r2p-old/uDC_module/hw/uDC_module.brd

## EAGLE design hw/uDC_module.brd (2015-01-22)

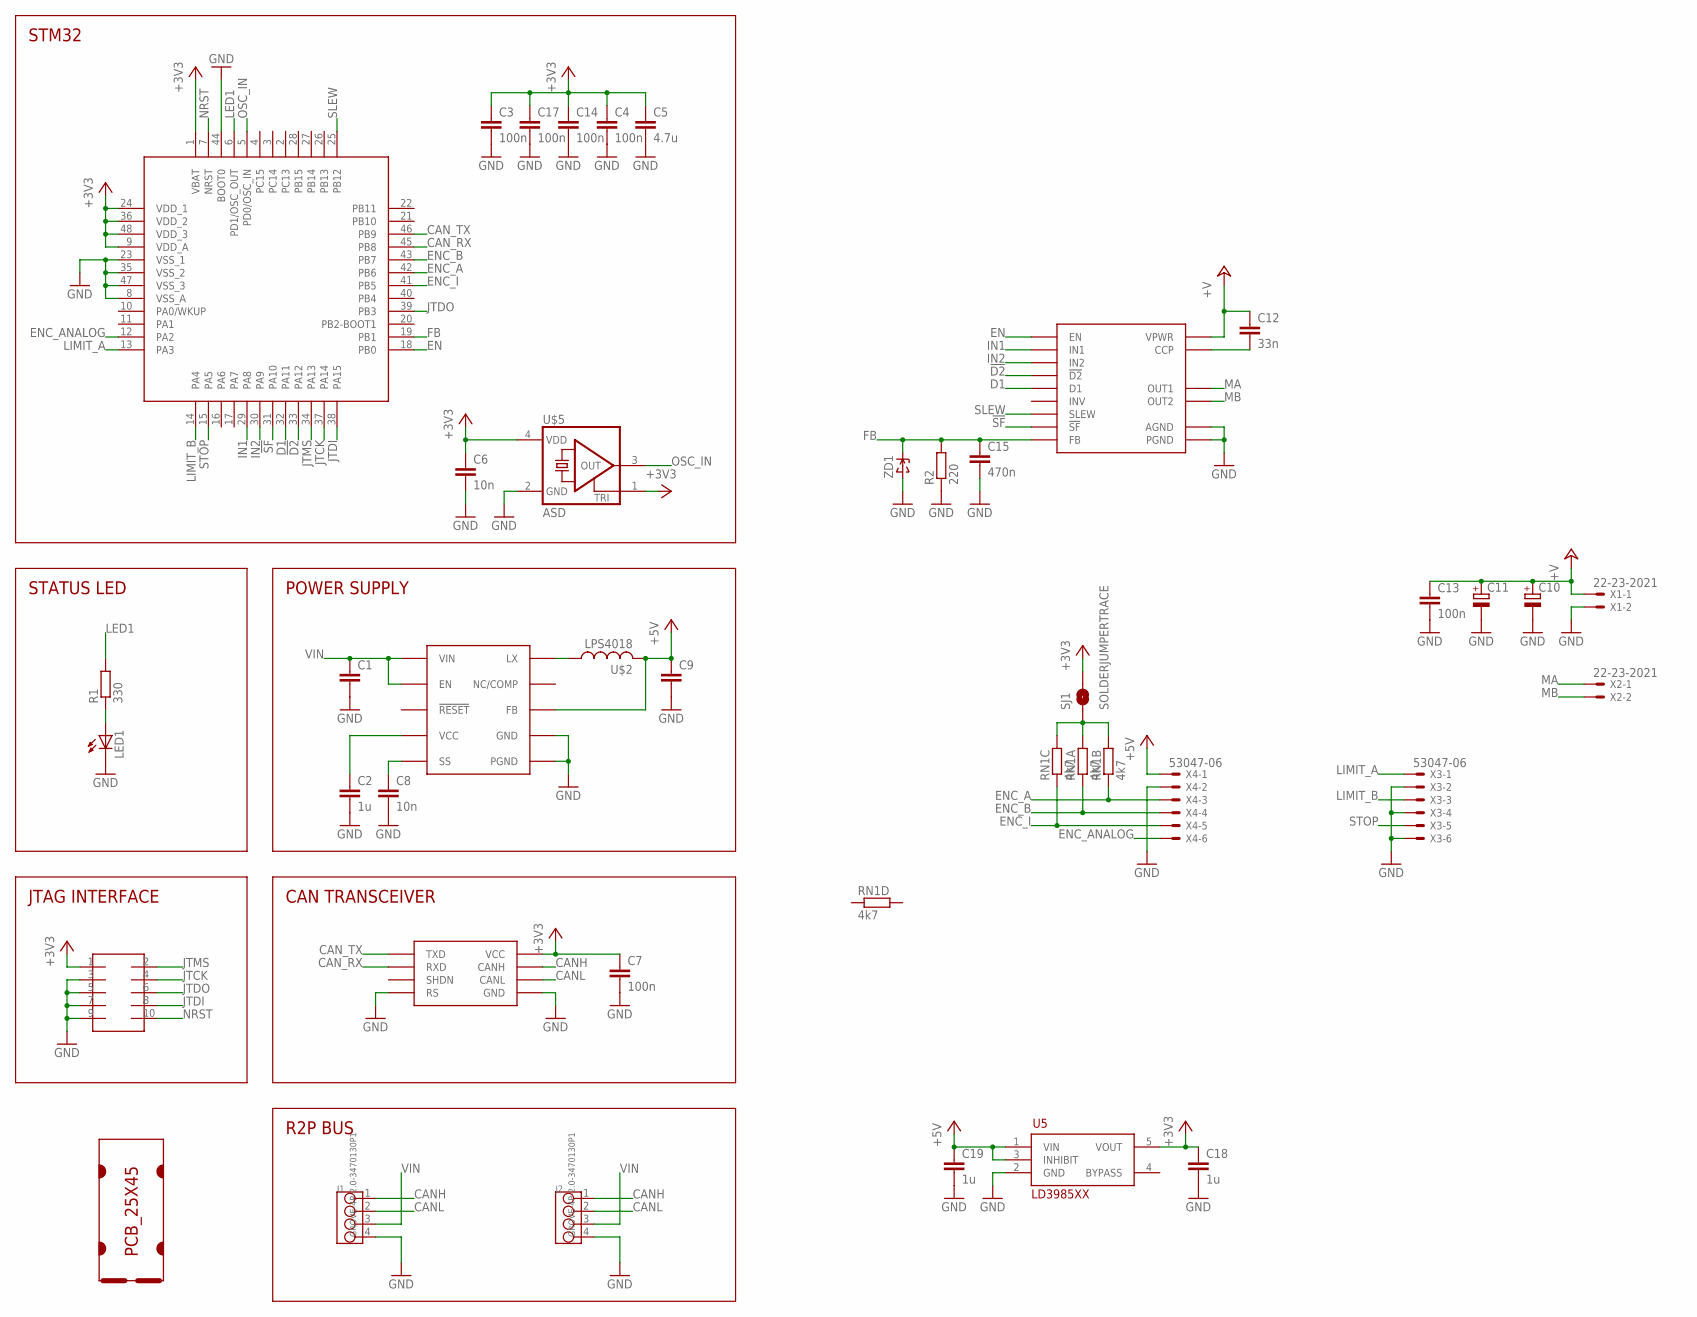
[picture p1: schematic uDC_module.sch]

Parts:
C1: C-EUC1206; C1206
C2, C18, C19: 1u; C0603
C3, C4, C7, C13, C14, C17: 100n; C0603
C5: 4.7u; C0805
C6, C8: 10n; C0603
C9: C-EUC0805; C0805
C10, C11: CPOL-EUD; PANASONIC_D
C12: 33n; C0603
C15: 470n; C0603
J1, J2: GROVE-4P-2.0-3470130P1; 4P-2.0
LED1: LEDCHIPLED_0805; CHIPLED_0805
R1: 330; R0603
R2: 220; R0603
RN1: 4k7; RN8P-4R-CRA06S
SJ1: SOLDERJUMPERTRACE; SJ_2S-TRACE
SOT1: MAX3051EKA; SOT23-8L
U5: LD3985XX; SOT23-5L
U$1: PCB_25X45; 25X45
U$2: LPS4018
U$3: MAX17501; TDFN-10
U$4: FTSH-105TH; FTSH-105-TH
U$5: ASD; 2.5X2
U$6: STM32F103CXTX; LQFP48
U$7: MC33962; PQFN32
X1, X2: 22-23-2021
X3, X4: 53047-06
ZD1: ZENERSOD-323F; SOD-323F

Connections:
!D2: U$6.33 (PA12), U$7.P$16 (!D2)
!SF: U$6.31 (PA10), U$7.P$21 (!SF)
+3V3: C3.1, C4.1, C5.1, C6.1, C7.1, C14.1, C17.1, C18.1, SJ1.2, SOT1.3 (VCC), U5.5 (VOUT), U$4.1, U$5.1 (TRI), U$5.4 (VDD), U$6.1 (VBAT), U$6.9 (VDD_A), U$6.24 (VDD_1), U$6.36 (VDD_2), U$6.48 (VDD_3)
+5V: C9.1, C19.1, U5.1 (VIN), U5.3 (INHIBIT), U$2.P$2 (2), U$3.P$5 (FB), X4.1
+V: C10.+, C11.+, C12.1, C13.1, U$7.P$4 (VPWR), U$7.P$6 (VPWR), U$7.P$11 (VPWR), U$7.P$31 (VPWR), X1.1
CANH: J1.1, J2.1, SOT1.7 (CANH)
CANL: J1.2, J2.2, SOT1.6 (CANL)
CAN_RX: SOT1.4 (RXD), U$6.45 (PB8)
CAN_TX: SOT1.1 (TXD), U$6.46 (PB9)
D1: U$6.32 (PA11), U$7.P$26 (D1)
EN: U$6.18 (PB0), U$7.P$10 (EN)
ENC_A: RN1.2 (1), U$6.42 (PB6), X4.3
ENC_ANALOG: U$6.12 (PA2), X4.6
ENC_B: RN1.1, U$6.43 (PB7), X4.4
ENC_I: RN1.3 (1), U$6.41 (PB5), X4.5
FB: C15.1, R2.2, U$6.19 (PB1), U$7.P$8 (FB), ZD1.C
GND: C1.2, C2.2, C3.2, C4.2, C5.2, C6.2, C7.2, C8.2, C9.2, C10.-, C11.-, C13.2, C14.2, C15.2, C17.2, C18.2, C19.2, J1.4, J2.4, LED1.C, R2.1, SOT1.2 (GND), SOT1.8 (RS), U5.2 (GND), U$3.P$1 (PGND), U$3.P$9 (GND), U$3.P$11 (PGND), U$4.3, U$4.5, U$4.7, U$4.9, U$5.2 (GND), U$6.8 (VSS_A), U$6.23 (VSS_1), U$6.35 (VSS_2), U$6.44 (BOOT0), U$6.47 (VSS_3), U$7.P$5 (AGND), U$7.P$18 (PGND), U$7.P$19 (PGND), U$7.P$20 (PGND), U$7.P$22 (PGND), U$7.P$23 (PGND), U$7.P$24 (PGND), U$7.P$33 (AGND), X1.2, X3.2, X3.4, X3.6, X4.2, ZD1.A
IN1: U$6.29 (PA8), U$7.P$2 (IN1)
IN2: U$6.30 (PA9), U$7.P$1 (IN2)
JTCK: U$4.4, U$6.37 (PA14)
JTDI: U$4.8, U$6.38 (PA15)
JTDO: U$4.6, U$6.39 (PB3)
JTMS: U$4.2, U$6.34 (PA13)
LED1: R1.2, U$6.6 (PD1/OSC_OUT)
LIMIT_A: U$6.13 (PA3), X3.1
LIMIT_B: U$6.14 (PA4), X3.3
MA: U$7.P$12 (OUT1), U$7.P$13 (OUT1), U$7.P$14 (OUT1), U$7.P$15 (OUT1), X2.1
MB: U$7.P$27 (OUT2), U$7.P$28 (OUT2), U$7.P$29 (OUT2), U$7.P$30 (OUT2), X2.2
unnamed: U$2.P$1 (1), U$3.P$10 (LX)
unnamed: LED1.A, R1.1
unnamed: RN1.6 (2), RN1.7 (2), RN1.8 (2), SJ1.1
unnamed: C12.2, U$7.P$32 (CCP)
unnamed: C2.1, U$3.P$4 (VCC)
unnamed: C8.1, U$3.P$6 (SS)
NRST: U$4.10, U$6.7 (NRST)
OSC_IN: U$5.3 (OUT), U$6.5 (PD0/OSC_IN)
SLEW: U$6.25 (PB12), U$7.P$3 (SLEW)
STOP: U$6.15 (PA5), X3.5
VIN: C1.1, J1.3, J2.3, U$3.P$2 (VIN), U$3.P$3 (EN)

Notes on the sheet:
STM32
STATUS LED
JTAG INTERFACE
POWER SUPPLY
CAN TRANSCEIVER
R2P BUS

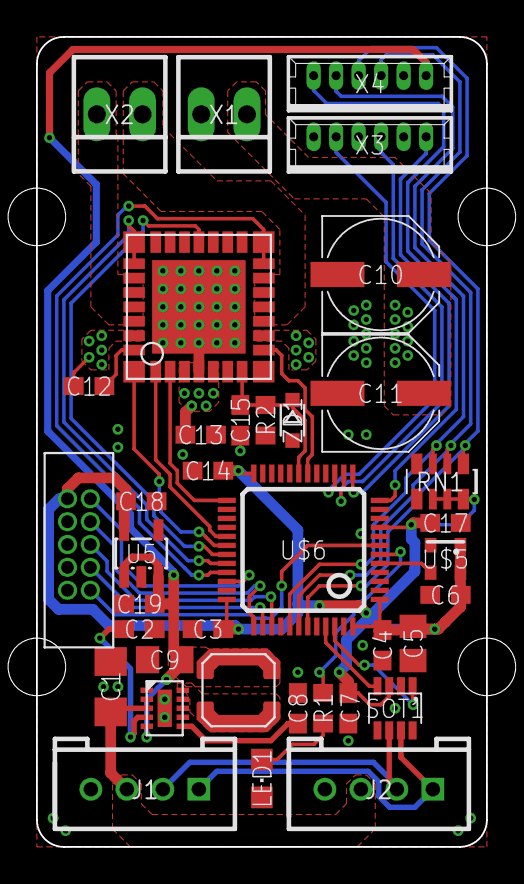
[picture p2: board uDC_module.brd from above]

Board: 2 copper layers, 25.0 x 45.0 mm, 39 parts (1 on the bottom side), 39 nets.
