r2p-old/uDC_module/fw/board.h

/*
    ChibiOS/RT - Copyright (C) 2006-2013 Giovanni Di Sirio

    Licensed under the Apache License, Version 2.0 (the "License");
    you may not use this file except in compliance with the License.
    You may obtain a copy of the License at

        http://www.apache.org/licenses/LICENSE-2.0

    Unless required by applicable law or agreed to in writing, software
    distributed under the License is distributed on an "AS IS" BASIS,
    WITHOUT WARRANTIES OR CONDITIONS OF ANY KIND, either express or implied.
    See the License for the specific language governing permissions and
    limitations under the License.
*/

#ifndef _BOARD_H_
#define _BOARD_H_

/*
 * Setup for R2P uDC module board.
 */

/*
 * Board identifier.
 */
#define BOARD_R2P_uDC_module
#define BOARD_NAME                  "R2P uDC module"

/*
 * Board oscillators-related settings.
 * NOTE: LSE not fitted.
 */
#if !defined(STM32_LSECLK)
#define STM32_LSECLK                0
#endif

#define STM32_LSEDRV                (3 << 3)

#if !defined(STM32_HSECLK)
#define STM32_HSECLK                24000000
#endif

#define STM32_HSE_BYPASS

#define PWM_DRIVER PWMD1
#define QEI_DRIVER QEID4


/*
 * MCU type as defined in the ST header.
 */
#define STM32F30X

/*
 * IO pins assignments.
 */
#define GPIOA_PIN0                  0
#define GPIOA_PIN1                  1
#define GPIOA_ENCODER_ANALOG        2
#define GPIOA_SWITCH_A              3
#define GPIOA_SWITCH_B              4
#define GPIOA_SWITCH_STOP           5
#define GPIOA_PIN6                  6
#define GPIOA_PIN7                  7
#define GPIOA_MOTOR_IN1             8
#define GPIOA_MOTOR_IN2             9
#define GPIOA_MOTOR_SF              10
#define GPIOA_MOTOR_D1              11
#define GPIOA_MOTOR_D2              12
#define GPIOA_JTAG_TMS              13
#define GPIOA_JTAG_TCK              14
#define GPIOA_JTAG_TDI              15

#define GPIOB_MOTOR_ENABLE          0
#define GPIOB_MOTOR_FEEDBACK        1
#define GPIOB_BOOT1                 2
#define GPIOB_JTAG_TDO              3
#define GPIOB_JTAG_TRST             4
#define GPIOB_ENCODER_I             5
#define GPIOB_ENCODER_A             6
#define GPIOB_ENCODER_B             7
#define GPIOB_CAN_RX                8
#define GPIOB_CAN_TX                9
#define GPIOB_PIN10                 10
#define GPIOB_PIN11                 11
#define GPIOB_MOTOR_SLEW            12
#define GPIOB_PIN13                 13
#define GPIOB_PIN14                 14
#define GPIOB_PIN15                 15

#define GPIOC_PIN0                  0
#define GPIOC_PIN1                  1
#define GPIOC_PIN2                  2
#define GPIOC_PIN3                  3
#define GPIOC_PIN4                  4
#define GPIOC_PIN5                  5
#define GPIOC_PIN6                  6
#define GPIOC_PIN7                  7
#define GPIOC_PIN8                  8
#define GPIOC_PIN9                  9
#define GPIOC_PIN10                 10
#define GPIOC_PIN11                 11
#define GPIOC_PIN12                 12
#define GPIOC_LED                   13
#define GPIOC_OSC32_IN              14
#define GPIOC_OSC32_OUT             15

#define GPIOD_PIN0                  0
#define GPIOD_PIN1                  1
#define GPIOD_PIN2                  2
#define GPIOD_PIN3                  3
#define GPIOD_PIN4                  4
#define GPIOD_PIN5                  5
#define GPIOD_PIN6                  6
#define GPIOD_PIN7                  7
#define GPIOD_PIN8                  8
#define GPIOD_PIN9                  9
#define GPIOD_PIN10                 10
#define GPIOD_PIN11                 11
#define GPIOD_PIN12                 12
#define GPIOD_PIN13                 13
#define GPIOD_PIN14                 14
#define GPIOD_PIN15                 15

#define GPIOE_PIN0                  0
#define GPIOE_PIN1                  1
#define GPIOE_PIN2                  2
#define GPIOE_PIN3                  3
#define GPIOE_PIN4                  4
#define GPIOE_PIN5                  5
#define GPIOE_PIN6                  6
#define GPIOE_PIN7                  7
#define GPIOE_PIN8                  8
#define GPIOE_PIN9                  9
#define GPIOE_PIN10                 10
#define GPIOE_PIN11                 11
#define GPIOE_PIN12                 12
#define GPIOE_PIN13                 13
#define GPIOE_PIN14                 14
#define GPIOE_PIN15                 15

#define GPIOF_PIN0                  0
#define GPIOF_LED                   1
#define GPIOF_PIN2                  2
#define GPIOF_PIN3                  3
#define GPIOF_PIN4                  4
#define GPIOF_PIN5                  5
#define GPIOF_PIN6                  6
#define GPIOF_PIN7                  7
#define GPIOF_PIN8                  8
#define GPIOF_PIN9                  9
#define GPIOF_PIN10                 10
#define GPIOF_PIN11                 11
#define GPIOF_PIN12                 12
#define GPIOF_PIN13                 13
#define GPIOF_PIN14                 14
#define GPIOF_PIN15                 15

#define LED1_GPIO	GPIOC
#define LED2_GPIO	GPIOC
#define LED3_GPIO	GPIOC
#define LED4_GPIO	GPIOC
#define LED1		13
#define LED2		13
#define LED3		13
#define LED4		13

/*
 * I/O ports initial setup, this configuration is established soon after reset
 * in the initialization code.
 * Please refer to the STM32 Reference Manual for details.
 */
#define PIN_MODE_INPUT(n)           (0U << ((n) * 2))
#define PIN_MODE_OUTPUT(n)          (1U << ((n) * 2))
#define PIN_MODE_ALTERNATE(n)       (2U << ((n) * 2))
#define PIN_MODE_ANALOG(n)          (3U << ((n) * 2))
#define PIN_ODR_LOW(n)              (0U << (n))
#define PIN_ODR_HIGH(n)             (1U << (n))
#define PIN_OTYPE_PUSHPULL(n)       (0U << (n))
#define PIN_OTYPE_OPENDRAIN(n)      (1U << (n))
#define PIN_OSPEED_2M(n)            (0U << ((n) * 2))
#define PIN_OSPEED_25M(n)           (1U << ((n) * 2))
#define PIN_OSPEED_50M(n)           (2U << ((n) * 2))
#define PIN_OSPEED_100M(n)          (3U << ((n) * 2))
#define PIN_PUPDR_FLOATING(n)       (0U << ((n) * 2))
#define PIN_PUPDR_PULLUP(n)         (1U << ((n) * 2))
#define PIN_PUPDR_PULLDOWN(n)       (2U << ((n) * 2))
#define PIN_AFIO_AF(n, v)           ((v##U) << ((n % 8) * 4))

/*
 * GPIOA setup:
 *
 * PA0  - PIN0                      (input pullup).
 * PA1  - PIN1                      (input pullup).
 * PA2  - ENCODER_ANALOG            (analog).
 * PA3  - SWITCH_A                  (input pullup).
 * PA4  - SWITCH_B                  (input pullup).
 * PA5  - SWITCH_STOP               (input pullup).
 * PA6  - PIN6                      (input pullup).
 * PA7  - PIN7                      (input pullup).
 * PA8  - MOTOR_IN1                 (alternate 6).
 * PA9  - MOTOR_IN2                 (alternate 6).
 * PA10 - MOTOR_SF                  (input pullup).
 * PA11 - MOTOR_D1                  (output pushpull maximum).
 * PA12 - MOTOR_D2                  (output pushpull maximum).
 * PA13 - JTAG_TMS                  (alternate 0).
 * PA14 - JTAG_TCK                  (alternate 0).
 * PA15 - JTAG_TDI                  (alternate 0).
 */
#define VAL_GPIOA_MODER             (PIN_MODE_INPUT(GPIOA_PIN0) |           \
                                     PIN_MODE_INPUT(GPIOA_PIN1) |           \
                                     PIN_MODE_ANALOG(GPIOA_ENCODER_ANALOG) |\
                                     PIN_MODE_INPUT(GPIOA_SWITCH_A) |       \
                                     PIN_MODE_INPUT(GPIOA_SWITCH_B) |       \
                                     PIN_MODE_INPUT(GPIOA_SWITCH_STOP) |    \
                                     PIN_MODE_INPUT(GPIOA_PIN6) |           \
                                     PIN_MODE_INPUT(GPIOA_PIN7) |           \
                                     PIN_MODE_ALTERNATE(GPIOA_MOTOR_IN1) |  \
                                     PIN_MODE_ALTERNATE(GPIOA_MOTOR_IN2) |  \
                                     PIN_MODE_INPUT(GPIOA_MOTOR_SF) |       \
                                     PIN_MODE_OUTPUT(GPIOA_MOTOR_D1) |      \
                                     PIN_MODE_OUTPUT(GPIOA_MOTOR_D2) |      \
                                     PIN_MODE_ALTERNATE(GPIOA_JTAG_TMS) |   \
                                     PIN_MODE_ALTERNATE(GPIOA_JTAG_TCK) |   \
                                     PIN_MODE_ALTERNATE(GPIOA_JTAG_TDI))
#define VAL_GPIOA_OTYPER            (PIN_OTYPE_PUSHPULL(GPIOA_PIN0) |       \
                                     PIN_OTYPE_PUSHPULL(GPIOA_PIN1) |       \
                                     PIN_OTYPE_PUSHPULL(GPIOA_ENCODER_ANALOG) |\
                                     PIN_OTYPE_PUSHPULL(GPIOA_SWITCH_A) |   \
                                     PIN_OTYPE_PUSHPULL(GPIOA_SWITCH_B) |   \
                                     PIN_OTYPE_PUSHPULL(GPIOA_SWITCH_STOP) |\
                                     PIN_OTYPE_PUSHPULL(GPIOA_PIN6) |       \
                                     PIN_OTYPE_PUSHPULL(GPIOA_PIN7) |       \
                                     PIN_OTYPE_PUSHPULL(GPIOA_MOTOR_IN1) |  \
                                     PIN_OTYPE_PUSHPULL(GPIOA_MOTOR_IN2) |  \
                                     PIN_OTYPE_PUSHPULL(GPIOA_MOTOR_SF) |   \
                                     PIN_OTYPE_PUSHPULL(GPIOA_MOTOR_D1) |   \
                                     PIN_OTYPE_PUSHPULL(GPIOA_MOTOR_D2) |   \
                                     PIN_OTYPE_PUSHPULL(GPIOA_JTAG_TMS) |   \
                                     PIN_OTYPE_PUSHPULL(GPIOA_JTAG_TCK) |   \
                                     PIN_OTYPE_PUSHPULL(GPIOA_JTAG_TDI))
#define VAL_GPIOA_OSPEEDR           (PIN_OSPEED_2M(GPIOA_PIN0) |            \
                                     PIN_OSPEED_2M(GPIOA_PIN1) |            \
                                     PIN_OSPEED_2M(GPIOA_ENCODER_ANALOG) |  \
                                     PIN_OSPEED_100M(GPIOA_SWITCH_A) |      \
                                     PIN_OSPEED_100M(GPIOA_SWITCH_B) |      \
                                     PIN_OSPEED_100M(GPIOA_SWITCH_STOP) |   \
                                     PIN_OSPEED_2M(GPIOA_PIN6) |            \
                                     PIN_OSPEED_2M(GPIOA_PIN7) |            \
                                     PIN_OSPEED_100M(GPIOA_MOTOR_IN1) |     \
                                     PIN_OSPEED_100M(GPIOA_MOTOR_IN2) |     \
                                     PIN_OSPEED_100M(GPIOA_MOTOR_SF) |      \
                                     PIN_OSPEED_100M(GPIOA_MOTOR_D1) |      \
                                     PIN_OSPEED_100M(GPIOA_MOTOR_D2) |      \
                                     PIN_OSPEED_100M(GPIOA_JTAG_TMS) |      \
                                     PIN_OSPEED_100M(GPIOA_JTAG_TCK) |      \
                                     PIN_OSPEED_100M(GPIOA_JTAG_TDI))
#define VAL_GPIOA_PUPDR             (PIN_PUPDR_PULLUP(GPIOA_PIN0) |         \
                                     PIN_PUPDR_PULLUP(GPIOA_PIN1) |         \
                                     PIN_PUPDR_FLOATING(GPIOA_ENCODER_ANALOG) |\
                                     PIN_PUPDR_PULLUP(GPIOA_SWITCH_A) |     \
                                     PIN_PUPDR_PULLUP(GPIOA_SWITCH_B) |     \
                                     PIN_PUPDR_PULLUP(GPIOA_SWITCH_STOP) |  \
                                     PIN_PUPDR_PULLUP(GPIOA_PIN6) |         \
                                     PIN_PUPDR_PULLUP(GPIOA_PIN7) |         \
                                     PIN_PUPDR_FLOATING(GPIOA_MOTOR_IN1) |  \
                                     PIN_PUPDR_FLOATING(GPIOA_MOTOR_IN2) |  \
                                     PIN_PUPDR_PULLUP(GPIOA_MOTOR_SF) |     \
                                     PIN_PUPDR_FLOATING(GPIOA_MOTOR_D1) |   \
                                     PIN_PUPDR_FLOATING(GPIOA_MOTOR_D2) |   \
                                     PIN_PUPDR_PULLUP(GPIOA_JTAG_TMS) |     \
                                     PIN_PUPDR_PULLDOWN(GPIOA_JTAG_TCK) |   \
                                     PIN_PUPDR_PULLUP(GPIOA_JTAG_TDI))
#define VAL_GPIOA_ODR               (PIN_ODR_HIGH(GPIOA_PIN0) |             \
                                     PIN_ODR_HIGH(GPIOA_PIN1) |             \
                                     PIN_ODR_HIGH(GPIOA_ENCODER_ANALOG) |   \
                                     PIN_ODR_HIGH(GPIOA_SWITCH_A) |         \
                                     PIN_ODR_HIGH(GPIOA_SWITCH_B) |         \
                                     PIN_ODR_HIGH(GPIOA_SWITCH_STOP) |      \
                                     PIN_ODR_HIGH(GPIOA_PIN6) |             \
                                     PIN_ODR_HIGH(GPIOA_PIN7) |             \
                                     PIN_ODR_HIGH(GPIOA_MOTOR_IN1) |        \
                                     PIN_ODR_HIGH(GPIOA_MOTOR_IN2) |        \
                                     PIN_ODR_HIGH(GPIOA_MOTOR_SF) |         \
                                     PIN_ODR_HIGH(GPIOA_MOTOR_D1) |         \
                                     PIN_ODR_HIGH(GPIOA_MOTOR_D2) |         \
                                     PIN_ODR_HIGH(GPIOA_JTAG_TMS) |         \
                                     PIN_ODR_HIGH(GPIOA_JTAG_TCK) |         \
                                     PIN_ODR_HIGH(GPIOA_JTAG_TDI))
#define VAL_GPIOA_AFRL              (PIN_AFIO_AF(GPIOA_PIN0, 0) |           \
                                     PIN_AFIO_AF(GPIOA_PIN1, 0) |           \
                                     PIN_AFIO_AF(GPIOA_ENCODER_ANALOG, 0) | \
                                     PIN_AFIO_AF(GPIOA_SWITCH_A, 0) |       \
                                     PIN_AFIO_AF(GPIOA_SWITCH_B, 0) |       \
                                     PIN_AFIO_AF(GPIOA_SWITCH_STOP, 0) |    \
                                     PIN_AFIO_AF(GPIOA_PIN6, 0) |           \
                                     PIN_AFIO_AF(GPIOA_PIN7, 0))
#define VAL_GPIOA_AFRH              (PIN_AFIO_AF(GPIOA_MOTOR_IN1, 6) |      \
                                     PIN_AFIO_AF(GPIOA_MOTOR_IN2, 6) |      \
                                     PIN_AFIO_AF(GPIOA_MOTOR_SF, 0) |       \
                                     PIN_AFIO_AF(GPIOA_MOTOR_D1, 0) |       \
                                     PIN_AFIO_AF(GPIOA_MOTOR_D2, 0) |       \
                                     PIN_AFIO_AF(GPIOA_JTAG_TMS, 0) |       \
                                     PIN_AFIO_AF(GPIOA_JTAG_TCK, 0) |       \
                                     PIN_AFIO_AF(GPIOA_JTAG_TDI, 0))

/*
 * GPIOB setup:
 *
 * PB0  - MOTOR_ENABLE              (output pushpull maximum).
 * PB1  - MOTOR_FEEDBACK            (analog).
 * PB2  - BOOT1                     (input floating).
 * PB3  - JTAG_TDO                  (alternate 0).
 * PB4  - JTAG_TRST                 (alternate 0).
 * PB5  - ENCODER_I                 (input pullup).
 * PB6  - ENCODER_A                 (alternate 2).
 * PB7  - ENCODER_B                 (alternate 2).
 * PB8  - CAN_RX                    (alternate 9).
 * PB9  - CAN_TX                    (alternate 9).
 * PB10 - PIN10                     (input pullup).
 * PB11 - PIN11                     (input pullup).
 * PB12 - MOTOR_SLEW                (output pushpull maximum).
 * PB13 - PIN13                     (input pullup).
 * PB14 - PIN14                     (input pullup).
 * PB15 - PIN15                     (input pullup).
 */
#define VAL_GPIOB_MODER             (PIN_MODE_OUTPUT(GPIOB_MOTOR_ENABLE) |  \
                                     PIN_MODE_ANALOG(GPIOB_MOTOR_FEEDBACK) |\
                                     PIN_MODE_INPUT(GPIOB_BOOT1) |          \
                                     PIN_MODE_ALTERNATE(GPIOB_JTAG_TDO) |   \
                                     PIN_MODE_ALTERNATE(GPIOB_JTAG_TRST) |  \
                                     PIN_MODE_INPUT(GPIOB_ENCODER_I) |      \
                                     PIN_MODE_ALTERNATE(GPIOB_ENCODER_A) |  \
                                     PIN_MODE_ALTERNATE(GPIOB_ENCODER_B) |  \
                                     PIN_MODE_ALTERNATE(GPIOB_CAN_RX) |     \
                                     PIN_MODE_ALTERNATE(GPIOB_CAN_TX) |     \
                                     PIN_MODE_INPUT(GPIOB_PIN10) |          \
                                     PIN_MODE_INPUT(GPIOB_PIN11) |          \
                                     PIN_MODE_OUTPUT(GPIOB_MOTOR_SLEW) |    \
                                     PIN_MODE_INPUT(GPIOB_PIN13) |          \
                                     PIN_MODE_INPUT(GPIOB_PIN14) |          \
                                     PIN_MODE_INPUT(GPIOB_PIN15))
#define VAL_GPIOB_OTYPER            (PIN_OTYPE_PUSHPULL(GPIOB_MOTOR_ENABLE) |\
                                     PIN_OTYPE_PUSHPULL(GPIOB_MOTOR_FEEDBACK) |\
                                     PIN_OTYPE_PUSHPULL(GPIOB_BOOT1) |      \
                                     PIN_OTYPE_PUSHPULL(GPIOB_JTAG_TDO) |   \
                                     PIN_OTYPE_PUSHPULL(GPIOB_JTAG_TRST) |  \
                                     PIN_OTYPE_PUSHPULL(GPIOB_ENCODER_I) |  \
                                     PIN_OTYPE_PUSHPULL(GPIOB_ENCODER_A) |  \
                                     PIN_OTYPE_PUSHPULL(GPIOB_ENCODER_B) |  \
                                     PIN_OTYPE_PUSHPULL(GPIOB_CAN_RX) |     \
                                     PIN_OTYPE_PUSHPULL(GPIOB_CAN_TX) |     \
                                     PIN_OTYPE_PUSHPULL(GPIOB_PIN10) |      \
                                     PIN_OTYPE_PUSHPULL(GPIOB_PIN11) |      \
                                     PIN_OTYPE_PUSHPULL(GPIOB_MOTOR_SLEW) | \
                                     PIN_OTYPE_PUSHPULL(GPIOB_PIN13) |      \
                                     PIN_OTYPE_PUSHPULL(GPIOB_PIN14) |      \
                                     PIN_OTYPE_PUSHPULL(GPIOB_PIN15))
#define VAL_GPIOB_OSPEEDR           (PIN_OSPEED_100M(GPIOB_MOTOR_ENABLE) |  \
                                     PIN_OSPEED_100M(GPIOB_MOTOR_FEEDBACK) |\
                                     PIN_OSPEED_100M(GPIOB_BOOT1) |         \
                                     PIN_OSPEED_100M(GPIOB_JTAG_TDO) |      \
                                     PIN_OSPEED_100M(GPIOB_JTAG_TRST) |     \
                                     PIN_OSPEED_100M(GPIOB_ENCODER_I) |     \
                                     PIN_OSPEED_100M(GPIOB_ENCODER_A) |     \
                                     PIN_OSPEED_100M(GPIOB_ENCODER_B) |     \
                                     PIN_OSPEED_100M(GPIOB_CAN_RX) |        \
                                     PIN_OSPEED_100M(GPIOB_CAN_TX) |        \
                                     PIN_OSPEED_2M(GPIOB_PIN10) |           \
                                     PIN_OSPEED_2M(GPIOB_PIN11) |           \
                                     PIN_OSPEED_100M(GPIOB_MOTOR_SLEW) |    \
                                     PIN_OSPEED_2M(GPIOB_PIN13) |           \
                                     PIN_OSPEED_2M(GPIOB_PIN14) |           \
                                     PIN_OSPEED_2M(GPIOB_PIN15))
#define VAL_GPIOB_PUPDR             (PIN_PUPDR_FLOATING(GPIOB_MOTOR_ENABLE) |\
                                     PIN_PUPDR_FLOATING(GPIOB_MOTOR_FEEDBACK) |\
                                     PIN_PUPDR_FLOATING(GPIOB_BOOT1) |      \
                                     PIN_PUPDR_FLOATING(GPIOB_JTAG_TDO) |   \
                                     PIN_PUPDR_PULLUP(GPIOB_JTAG_TRST) |    \
                                     PIN_PUPDR_PULLUP(GPIOB_ENCODER_I) |    \
                                     PIN_PUPDR_PULLUP(GPIOB_ENCODER_A) |    \
                                     PIN_PUPDR_PULLUP(GPIOB_ENCODER_B) |    \
                                     PIN_PUPDR_FLOATING(GPIOB_CAN_RX) |     \
                                     PIN_PUPDR_FLOATING(GPIOB_CAN_TX) |     \
                                     PIN_PUPDR_PULLUP(GPIOB_PIN10) |        \
                                     PIN_PUPDR_PULLUP(GPIOB_PIN11) |        \
                                     PIN_PUPDR_FLOATING(GPIOB_MOTOR_SLEW) | \
                                     PIN_PUPDR_PULLUP(GPIOB_PIN13) |        \
                                     PIN_PUPDR_PULLUP(GPIOB_PIN14) |        \
                                     PIN_PUPDR_PULLUP(GPIOB_PIN15))
#define VAL_GPIOB_ODR               (PIN_ODR_LOW(GPIOB_MOTOR_ENABLE) |      \
                                     PIN_ODR_HIGH(GPIOB_MOTOR_FEEDBACK) |   \
                                     PIN_ODR_HIGH(GPIOB_BOOT1) |            \
                                     PIN_ODR_HIGH(GPIOB_JTAG_TDO) |         \
                                     PIN_ODR_HIGH(GPIOB_JTAG_TRST) |        \
                                     PIN_ODR_HIGH(GPIOB_ENCODER_I) |        \
                                     PIN_ODR_HIGH(GPIOB_ENCODER_A) |        \
                                     PIN_ODR_HIGH(GPIOB_ENCODER_B) |        \
                                     PIN_ODR_HIGH(GPIOB_CAN_RX) |           \
                                     PIN_ODR_HIGH(GPIOB_CAN_TX) |           \
                                     PIN_ODR_HIGH(GPIOB_PIN10) |            \
                                     PIN_ODR_HIGH(GPIOB_PIN11) |            \
                                     PIN_ODR_HIGH(GPIOB_MOTOR_SLEW) |       \
                                     PIN_ODR_HIGH(GPIOB_PIN13) |            \
                                     PIN_ODR_HIGH(GPIOB_PIN14) |            \
                                     PIN_ODR_HIGH(GPIOB_PIN15))
#define VAL_GPIOB_AFRL              (PIN_AFIO_AF(GPIOB_MOTOR_ENABLE, 0) |   \
                                     PIN_AFIO_AF(GPIOB_MOTOR_FEEDBACK, 0) | \
                                     PIN_AFIO_AF(GPIOB_BOOT1, 0) |          \
                                     PIN_AFIO_AF(GPIOB_JTAG_TDO, 0) |       \
                                     PIN_AFIO_AF(GPIOB_JTAG_TRST, 0) |      \
                                     PIN_AFIO_AF(GPIOB_ENCODER_I, 0) |      \
                                     PIN_AFIO_AF(GPIOB_ENCODER_A, 2) |      \
                                     PIN_AFIO_AF(GPIOB_ENCODER_B, 2))
#define VAL_GPIOB_AFRH              (PIN_AFIO_AF(GPIOB_CAN_RX, 9) |         \
                                     PIN_AFIO_AF(GPIOB_CAN_TX, 9) |         \
                                     PIN_AFIO_AF(GPIOB_PIN10, 0) |          \
                                     PIN_AFIO_AF(GPIOB_PIN11, 0) |          \
                                     PIN_AFIO_AF(GPIOB_MOTOR_SLEW, 0) |     \
                                     PIN_AFIO_AF(GPIOB_PIN13, 0) |          \
                                     PIN_AFIO_AF(GPIOB_PIN14, 0) |          \
                                     PIN_AFIO_AF(GPIOB_PIN15, 0))

/*
 * GPIOC setup:
 *
 * PC0  - PIN0                      (input pullup).
 * PC1  - PIN1                      (input pullup).
 * PC2  - PIN2                      (input pullup).
 * PC3  - PIN3                      (input pullup).
 * PC4  - PIN4                      (input pullup).
 * PC5  - PIN5                      (input pullup).
 * PC6  - PIN6                      (input pullup).
 * PC7  - PIN7                      (input pullup).
 * PC8  - PIN8                      (input pullup).
 * PC9  - PIN9                      (input pullup).
 * PC10 - PIN10                     (input pullup).
 * PC11 - PIN11                     (input pullup).
 * PC12 - PIN12                     (input pullup).
 * PC13 - LED                       (output pushpull minimum).
 * PC14 - OSC32_IN                  (input floating).
 * PC15 - OSC32_OUT                 (input floating).
 */
#define VAL_GPIOC_MODER             (PIN_MODE_INPUT(GPIOC_PIN0) |           \
                                     PIN_MODE_INPUT(GPIOC_PIN1) |           \
                                     PIN_MODE_INPUT(GPIOC_PIN2) |           \
                                     PIN_MODE_INPUT(GPIOC_PIN3) |           \
                                     PIN_MODE_INPUT(GPIOC_PIN4) |           \
                                     PIN_MODE_INPUT(GPIOC_PIN5) |           \
                                     PIN_MODE_INPUT(GPIOC_PIN6) |           \
                                     PIN_MODE_INPUT(GPIOC_PIN7) |           \
                                     PIN_MODE_INPUT(GPIOC_PIN8) |           \
                                     PIN_MODE_INPUT(GPIOC_PIN9) |           \
                                     PIN_MODE_INPUT(GPIOC_PIN10) |          \
                                     PIN_MODE_INPUT(GPIOC_PIN11) |          \
                                     PIN_MODE_INPUT(GPIOC_PIN12) |          \
                                     PIN_MODE_OUTPUT(GPIOC_LED) |           \
                                     PIN_MODE_INPUT(GPIOC_OSC32_IN) |       \
                                     PIN_MODE_INPUT(GPIOC_OSC32_OUT))
#define VAL_GPIOC_OTYPER            (PIN_OTYPE_PUSHPULL(GPIOC_PIN0) |       \
                                     PIN_OTYPE_PUSHPULL(GPIOC_PIN1) |       \
                                     PIN_OTYPE_PUSHPULL(GPIOC_PIN2) |       \
                                     PIN_OTYPE_PUSHPULL(GPIOC_PIN3) |       \
                                     PIN_OTYPE_PUSHPULL(GPIOC_PIN4) |       \
                                     PIN_OTYPE_PUSHPULL(GPIOC_PIN5) |       \
                                     PIN_OTYPE_PUSHPULL(GPIOC_PIN6) |       \
                                     PIN_OTYPE_PUSHPULL(GPIOC_PIN7) |       \
                                     PIN_OTYPE_PUSHPULL(GPIOC_PIN8) |       \
                                     PIN_OTYPE_PUSHPULL(GPIOC_PIN9) |       \
                                     PIN_OTYPE_PUSHPULL(GPIOC_PIN10) |      \
                                     PIN_OTYPE_PUSHPULL(GPIOC_PIN11) |      \
                                     PIN_OTYPE_PUSHPULL(GPIOC_PIN12) |      \
                                     PIN_OTYPE_PUSHPULL(GPIOC_LED) |        \
                                     PIN_OTYPE_PUSHPULL(GPIOC_OSC32_IN) |   \
                                     PIN_OTYPE_PUSHPULL(GPIOC_OSC32_OUT))
#define VAL_GPIOC_OSPEEDR           (PIN_OSPEED_2M(GPIOC_PIN0) |            \
                                     PIN_OSPEED_2M(GPIOC_PIN1) |            \
                                     PIN_OSPEED_2M(GPIOC_PIN2) |            \
                                     PIN_OSPEED_2M(GPIOC_PIN3) |            \
                                     PIN_OSPEED_2M(GPIOC_PIN4) |            \
                                     PIN_OSPEED_2M(GPIOC_PIN5) |            \
                                     PIN_OSPEED_2M(GPIOC_PIN6) |            \
                                     PIN_OSPEED_2M(GPIOC_PIN7) |            \
                                     PIN_OSPEED_2M(GPIOC_PIN8) |            \
                                     PIN_OSPEED_2M(GPIOC_PIN9) |            \
                                     PIN_OSPEED_2M(GPIOC_PIN10) |           \
                                     PIN_OSPEED_2M(GPIOC_PIN11) |           \
                                     PIN_OSPEED_2M(GPIOC_PIN12) |           \
                                     PIN_OSPEED_2M(GPIOC_LED) |             \
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
                                     PIN_AFIO_AF(GPIOE_PIN13, 0) |          \
                                     PIN_AFIO_AF(GPIOE_PIN14, 0) |          \
                                     PIN_AFIO_AF(GPIOE_PIN15, 0))

/*
 * GPIOF setup:
 *
 * PF0  - PIN0                      (input pullup).
 * PF1  - LED                       (output pushpull minimum).
 * PF2  - PIN2                      (input pullup).
 * PF3  - PIN3                      (input pullup).
 * PF4  - PIN4                      (input pullup).
 * PF5  - PIN5                      (input pullup).
 * PF6  - PIN6                      (input pullup).
 * PF7  - PIN7                      (input pullup).
 * PF8  - PIN8                      (input pullup).
 * PF9  - PIN9                      (input pullup).
 * PF10 - PIN10                     (input pullup).
 * PF11 - PIN11                     (input pullup).
 * PF12 - PIN12                     (input pullup).
 * PF13 - PIN13                     (input pullup).
 * PF14 - PIN14                     (input pullup).
 * PF15 - PIN15                     (input pullup).
 */
#define VAL_GPIOF_MODER             (PIN_MODE_INPUT(GPIOF_PIN0) |           \
                                     PIN_MODE_OUTPUT(GPIOF_LED) |           \
                                     PIN_MODE_INPUT(GPIOF_PIN2) |           \
                                     PIN_MODE_INPUT(GPIOF_PIN3) |           \
                                     PIN_MODE_INPUT(GPIOF_PIN4) |           \
                                     PIN_MODE_INPUT(GPIOF_PIN5) |           \
                                     PIN_MODE_INPUT(GPIOF_PIN6) |           \
                                     PIN_MODE_INPUT(GPIOF_PIN7) |           \
                                     PIN_MODE_INPUT(GPIOF_PIN8) |           \
                                     PIN_MODE_INPUT(GPIOF_PIN9) |           \
                                     PIN_MODE_INPUT(GPIOF_PIN10) |          \
                                     PIN_MODE_INPUT(GPIOF_PIN11) |          \
                                     PIN_MODE_INPUT(GPIOF_PIN12) |          \
                                     PIN_MODE_INPUT(GPIOF_PIN13) |          \
                                     PIN_MODE_INPUT(GPIOF_PIN14) |          \
                                     PIN_MODE_INPUT(GPIOF_PIN15))
#define VAL_GPIOF_OTYPER            (PIN_OTYPE_PUSHPULL(GPIOF_PIN0) |       \
                                     PIN_OTYPE_PUSHPULL(GPIOF_LED) |        \
                                     PIN_OTYPE_PUSHPULL(GPIOF_PIN2) |       \
                                     PIN_OTYPE_PUSHPULL(GPIOF_PIN3) |       \
                                     PIN_OTYPE_PUSHPULL(GPIOF_PIN4) |       \
                                     PIN_OTYPE_PUSHPULL(GPIOF_PIN5) |       \
                                     PIN_OTYPE_PUSHPULL(GPIOF_PIN6) |       \
                                     PIN_OTYPE_PUSHPULL(GPIOF_PIN7) |       \
                                     PIN_OTYPE_PUSHPULL(GPIOF_PIN8) |       \
                                     PIN_OTYPE_PUSHPULL(GPIOF_PIN9) |       \
                                     PIN_OTYPE_PUSHPULL(GPIOF_PIN10) |      \
                                     PIN_OTYPE_PUSHPULL(GPIOF_PIN11) |      \
                                     PIN_OTYPE_PUSHPULL(GPIOF_PIN12) |      \
                                     PIN_OTYPE_PUSHPULL(GPIOF_PIN13) |      \
                                     PIN_OTYPE_PUSHPULL(GPIOF_PIN14) |      \
                                     PIN_OTYPE_PUSHPULL(GPIOF_PIN15))
#define VAL_GPIOF_OSPEEDR           (PIN_OSPEED_2M(GPIOF_PIN0) |            \
                                     PIN_OSPEED_2M(GPIOF_LED) |             \
                                     PIN_OSPEED_2M(GPIOF_PIN2) |            \
                                     PIN_OSPEED_2M(GPIOF_PIN3) |            \
                                     PIN_OSPEED_2M(GPIOF_PIN4) |            \
                                     PIN_OSPEED_2M(GPIOF_PIN5) |            \
                                     PIN_OSPEED_2M(GPIOF_PIN6) |            \
                                     PIN_OSPEED_2M(GPIOF_PIN7) |            \
                                     PIN_OSPEED_2M(GPIOF_PIN8) |            \
                                     PIN_OSPEED_2M(GPIOF_PIN9) |            \
                                     PIN_OSPEED_2M(GPIOF_PIN10) |           \
                                     PIN_OSPEED_2M(GPIOF_PIN11) |           \
                                     PIN_OSPEED_2M(GPIOF_PIN12) |           \
                                     PIN_OSPEED_2M(GPIOF_PIN13) |           \
                                     PIN_OSPEED_2M(GPIOF_PIN14) |           \
                                     PIN_OSPEED_2M(GPIOF_PIN15))
#define VAL_GPIOF_PUPDR             (PIN_PUPDR_PULLUP(GPIOF_PIN0) |         \
                                     PIN_PUPDR_PULLUP(GPIOF_LED) |          \
                                     PIN_PUPDR_PULLUP(GPIOF_PIN2) |         \
                                     PIN_PUPDR_PULLUP(GPIOF_PIN3) |         \
                                     PIN_PUPDR_PULLUP(GPIOF_PIN4) |         \
                                     PIN_PUPDR_PULLUP(GPIOF_PIN5) |         \
                                     PIN_PUPDR_PULLUP(GPIOF_PIN6) |         \
                                     PIN_PUPDR_PULLUP(GPIOF_PIN7) |         \
                                     PIN_PUPDR_PULLUP(GPIOF_PIN8) |         \
                                     PIN_PUPDR_PULLUP(GPIOF_PIN9) |         \
                                     PIN_PUPDR_PULLUP(GPIOF_PIN10) |        \
                                     PIN_PUPDR_PULLUP(GPIOF_PIN11) |        \
                                     PIN_PUPDR_PULLUP(GPIOF_PIN12) |        \
                                     PIN_PUPDR_PULLUP(GPIOF_PIN13) |        \
                                     PIN_PUPDR_PULLUP(GPIOF_PIN14) |        \
                                     PIN_PUPDR_PULLUP(GPIOF_PIN15))
#define VAL_GPIOF_ODR               (PIN_ODR_HIGH(GPIOF_PIN0) |             \
                                     PIN_ODR_LOW(GPIOF_LED) |               \
                                     PIN_ODR_HIGH(GPIOF_PIN2) |             \
                                     PIN_ODR_HIGH(GPIOF_PIN3) |             \
                                     PIN_ODR_HIGH(GPIOF_PIN4) |             \
                                     PIN_ODR_HIGH(GPIOF_PIN5) |             \
                                     PIN_ODR_HIGH(GPIOF_PIN6) |             \
                                     PIN_ODR_HIGH(GPIOF_PIN7) |             \
                                     PIN_ODR_HIGH(GPIOF_PIN8) |             \
                                     PIN_ODR_HIGH(GPIOF_PIN9) |             \
                                     PIN_ODR_HIGH(GPIOF_PIN10) |            \
                                     PIN_ODR_HIGH(GPIOF_PIN11) |            \
                                     PIN_ODR_HIGH(GPIOF_PIN12) |            \
                                     PIN_ODR_HIGH(GPIOF_PIN13) |            \
                                     PIN_ODR_HIGH(GPIOF_PIN14) |            \
                                     PIN_ODR_HIGH(GPIOF_PIN15))
#define VAL_GPIOF_AFRL              (PIN_AFIO_AF(GPIOF_PIN0, 0) |           \
                                     PIN_AFIO_AF(GPIOF_LED, 0) |            \
                                     PIN_AFIO_AF(GPIOF_PIN2, 0) |           \
                                     PIN_AFIO_AF(GPIOF_PIN3, 0) |           \
                                     PIN_AFIO_AF(GPIOF_PIN4, 0) |           \
                                     PIN_AFIO_AF(GPIOF_PIN5, 0) |           \
                                     PIN_AFIO_AF(GPIOF_PIN6, 0) |           \
                                     PIN_AFIO_AF(GPIOF_PIN7, 0))
#define VAL_GPIOF_AFRH              (PIN_AFIO_AF(GPIOF_PIN8, 0) |           \
                                     PIN_AFIO_AF(GPIOF_PIN9, 0) |           \
                                     PIN_AFIO_AF(GPIOF_PIN10, 0) |          \
                                     PIN_AFIO_AF(GPIOF_PIN11, 0) |          \
                                     PIN_AFIO_AF(GPIOF_PIN12, 0) |          \
                                     PIN_AFIO_AF(GPIOF_PIN13, 0) |          \
                                     PIN_AFIO_AF(GPIOF_PIN14, 0) |          \
                                     PIN_AFIO_AF(GPIOF_PIN15, 0))


#if !defined(_FROM_ASM_)
#ifdef __cplusplus
extern "C" {
#endif
  void boardInit(void);
#ifdef __cplusplus
}
#endif
#endif /* _FROM_ASM_ */

#endif /* _BOARD_H_ */
