r2p-old/uDC_module/fw/qei_lld.h

/*
    ChibiOS/RT - Copyright (C) 2006,2007,2009,2009,2010,
                 2011,2012 Giovanni Di Sirio.

    This file is part of ChibiOS/RT.

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
    You should have received a copy of the GNU General Public License
    along with this program.  If not, see <http://www.gnu.org/licenses/>.
*/

/**
 * @file    STM32/qei_lld.h
 * @brief   STM32 QEI subsystem low level driver header.
 *
 * @addtogroup QEI
 * @{
 */

#ifndef _QEI_LLD_H_
#define _QEI_LLD_H_

#include "stm32_tim.h"

#if HAL_USE_QEI || defined(__DOXYGEN__)

/*===========================================================================*/
/* Driver constants.                                                         */
/*===========================================================================*/

/*===========================================================================*/
/* Driver pre-compile time settings.                                         */
/*===========================================================================*/

/**
 * @name    Configuration options
 * @{
 */
/**
 * @brief   QEID1 driver enable switch.
 * @details If set to @p TRUE the support for QEID1 is included.
 * @note    The default is @p TRUE.
 */
#if !defined(STM32_QEI_USE_TIM1) || defined(__DOXYGEN__)
#define STM32_QEI_USE_TIM1                  FALSE
#endif

/**
 * @brief   QEID2 driver enable switch.
 * @details If set to @p TRUE the support for QEID2 is included.
 * @note    The default is @p TRUE.
 */
#if !defined(STM32_QEI_USE_TIM2) || defined(__DOXYGEN__)
#define STM32_QEI_USE_TIM2                  FALSE
#endif

/**
 * @brief   QEID3 driver enable switch.
 * @details If set to @p TRUE the support for QEID3 is included.
 * @note    The default is @p TRUE.
 */
#if !defined(STM32_QEI_USE_TIM3) || defined(__DOXYGEN__)
#define STM32_QEI_USE_TIM3                  FALSE
#endif

/**
 * @brief   QEID4 driver enable switch.
 * @details If set to @p TRUE the support for QEID4 is included.
 * @note    The default is @p TRUE.
 */
#if !defined(STM32_QEI_USE_TIM4) || defined(__DOXYGEN__)
#define STM32_QEI_USE_TIM4                  FALSE
#endif

/**
 * @brief   QEID5 driver enable switch.
 * @details If set to @p TRUE the support for QEID5 is included.
 * @note    The default is @p TRUE.
 */
#if !defined(STM32_QEI_USE_TIM5) || defined(__DOXYGEN__)
#define STM32_QEI_USE_TIM5                  FALSE
#endif

/**
 * @brief   QEID8 driver enable switch.
 * @details If set to @p TRUE the support for QEID8 is included.
 * @note    The default is @p TRUE.
 */
#if !defined(STM32_QEI_USE_TIM8) || defined(__DOXYGEN__)
#define STM32_QEI_USE_TIM8                  FALSE
#endif

/**
 * @brief   QEID9 driver enable switch.
 * @details If set to @p TRUE the support for QEID9 is included.
 * @note    The default is @p TRUE.
 */
#if !defined(STM32_QEI_USE_TIM9) || defined(__DOXYGEN__)
#define STM32_QEI_USE_TIM9                  FALSE
#endif

/**
 * @brief   QEID1 interrupt priority level setting.
 */
#if !defined(STM32_QEI_TIM1_IRQ_PRIORITY) || defined(__DOXYGEN__)
#define STM32_QEI_TIM1_IRQ_PRIORITY         7
#endif

/**
 * @brief   QEID2 interrupt priority level setting.
 */
#if !defined(STM32_QEI_TIM2_IRQ_PRIORITY) || defined(__DOXYGEN__)
#define STM32_QEI_TIM2_IRQ_PRIORITY         7
#endif

/**
 * @brief   QEID3 interrupt priority level setting.
 */
#if !defined(STM32_QEI_TIM3_IRQ_PRIORITY) || defined(__DOXYGEN__)
#define STM32_QEI_TIM3_IRQ_PRIORITY         7
#endif

/**
 * @brief   QEID4 interrupt priority level setting.
 */
#if !defined(STM32_QEI_TIM4_IRQ_PRIORITY) || defined(__DOXYGEN__)
#define STM32_QEI_TIM4_IRQ_PRIORITY         7
#endif

/**
 * @brief   QEID5 interrupt priority level setting.
 */
#if !defined(STM32_QEI_TIM5_IRQ_PRIORITY) || defined(__DOXYGEN__)
#define STM32_QEI_TIM5_IRQ_PRIORITY         7
#endif

/**
 * @brief   QEID8 interrupt priority level setting.
 */
#if !defined(STM32_QEI_TIM8_IRQ_PRIORITY) || defined(__DOXYGEN__)
#define STM32_QEI_TIM8_IRQ_PRIORITY         7
#endif

/**
 * @brief   QEID9 interrupt priority level setting.
 */
#if !defined(STM32_QEI_TIM9_IRQ_PRIORITY) || defined(__DOXYGEN__)
#define STM32_QEI_TIM9_IRQ_PRIORITY         7
#endif
/** @} */

/*===========================================================================*/
/* Derived constants and error checks.                                       */
/*===========================================================================*/

#if STM32_QEI_USE_TIM1 && !STM32_HAS_TIM1
#error "TIM1 not present in the selected device"
#endif

#if STM32_QEI_USE_TIM2 && !STM32_HAS_TIM2
#error "TIM2 not present in the selected device"
#endif

#if STM32_QEI_USE_TIM3 && !STM32_HAS_TIM3
#error "TIM3 not present in the selected device"
#endif

#if STM32_QEI_USE_TIM4 && !STM32_HAS_TIM4
#error "TIM4 not present in the selected device"
#endif

#if STM32_QEI_USE_TIM5 && !STM32_HAS_TIM5
#error "TIM5 not present in the selected device"
#endif

#if STM32_QEI_USE_TIM9 && !STM32_HAS_TIM9
#error "TIM9 not present in the selected device"
#endif

#if !STM32_QEI_USE_TIM1 && !STM32_QEI_USE_TIM2 &&                           \
    !STM32_QEI_USE_TIM3 && !STM32_QEI_USE_TIM4 &&                           \
    !STM32_QEI_USE_TIM5 && !STM32_QEI_USE_TIM9
#error "QEI driver activated but no TIM peripheral assigned"
#endif

#if STM32_QEI_USE_TIM1 &&                                                   \
    !CORTEX_IS_VALID_KERNEL_PRIORITY(STM32_QEI_TIM1_IRQ_PRIORITY)
#error "Invalid IRQ priority assigned to TIM1"
#endif

#if STM32_QEI_USE_TIM2 &&                                                   \
    !CORTEX_IS_VALID_KERNEL_PRIORITY(STM32_QEI_TIM2_IRQ_PRIORITY)
#error "Invalid IRQ priority assigned to TIM2"
#endif

#if STM32_QEI_USE_TIM3 &&                                                   \
    !CORTEX_IS_VALID_KERNEL_PRIORITY(STM32_QEI_TIM3_IRQ_PRIORITY)
#error "Invalid IRQ priority assigned to TIM3"
#endif

#if STM32_QEI_USE_TIM4 &&                                                   \
    !CORTEX_IS_VALID_KERNEL_PRIORITY(STM32_QEI_TIM4_IRQ_PRIORITY)
#error "Invalid IRQ priority assigned to TIM4"
#endif

#if STM32_QEI_USE_TIM5 &&                                                   \
    !CORTEX_IS_VALID_KERNEL_PRIORITY(STM32_QEI_TIM5_IRQ_PRIORITY)
#error "Invalid IRQ priority assigned to TIM5"
#endif

#if STM32_QEI_USE_TIM9 &&                                                   \
    !CORTEX_IS_VALID_KERNEL_PRIORITY(STM32_QEI_TIM9_IRQ_PRIORITY)
#error "Invalid IRQ priority assigned to TIM9"
#endif

/*===========================================================================*/
/* Driver data structures and types.                                         */
/*===========================================================================*/

/**
 * @brief   QEI count mode.
 */
typedef enum {
  QEI_MODE_QUADRATURE = 0,          /**< Quadrature encoder mode.           */
  QEI_MODE_DIRCLOCK1 = 1,            /**< Direction/Clock mode 1 (IN1=DIR). */
  QEI_MODE_DIRCLOCK2 = 2,            /**< Direction/Clock mode 2 (IN2=DIR). */
} qeimode_t;

/**
 * @brief   QEI resolution.
 */
typedef enum {
  QEI_SINGLE_EDGE = 0,        /**< Count only on edges from first channel.  */
  QEI_BOTH_EDGES = 1,         /**< Count on both edges (resolution doubles).*/
} qeiresolution_t;

/**
 * @brief   QEI direction inversion.
 */
typedef enum {
  QEI_DIRINV_FALSE = 0,             /**< Do not invert counter direction.   */
  QEI_DIRINV_TRUE = 1,              /**< Invert counter direction.          */
} qeidirinv_t;

/**
 * @brief   QEI counter type.
 */
typedef uint16_t qeicnt_t;

/**
 * @brief   QEI delta type.
 */
typedef int16_t qeidelta_t;

/**
 * @brief   Driver configuration structure.
 * @note    It could be empty on some architectures.
 */
typedef struct {
  /**
   * @brief   Count mode.
   */
  qeimode_t                 mode;
  /**
   * @brief   Resolution.
   */
  qeiresolution_t           resolution;
  /**
   * @brief   Direction inversion.
   */
  qeidirinv_t               dirinv;
  /* End of the mandatory fields.*/
} QEIConfig;

/**
 * @brief   Structure representing an QEI driver.
 */
struct QEIDriver {
  /**
   * @brief Driver state.
   */
  qeistate_t                state;
  /**
   * @brief Last count value.
   */
  qeicnt_t                  last;
  /**
   * @brief Current configuration data.
   */
  const QEIConfig           *config;
#if defined(QEI_DRIVER_EXT_FIELDS)
  QEI_DRIVER_EXT_FIELDS
#endif
  /* End of the mandatory fields.*/
  /**
   * @brief Pointer to the TIMx registers block.
   */
  stm32_tim_t               *tim;
};

/*===========================================================================*/
/* Driver macros.                                                            */
/*===========================================================================*/

/**
 * @brief   Returns the counter value.
 *
 * @param[in] qeip      pointer to the @p QEIDriver object
 * @return              The current counter value.
 *
 * @notapi
 */
#define qei_lld_get_count(qeip) ((qeip)->tim->CNT)

/*===========================================================================*/
/* External declarations.                                                    */
/*===========================================================================*/

#if STM32_QEI_USE_TIM1 && !defined(__DOXYGEN__)
extern QEIDriver QEID1;
#endif

#if STM32_QEI_USE_TIM2 && !defined(__DOXYGEN__)
extern QEIDriver QEID2;
#endif

#if STM32_QEI_USE_TIM3 && !defined(__DOXYGEN__)
extern QEIDriver QEID3;
#endif

#if STM32_QEI_USE_TIM4 && !defined(__DOXYGEN__)
extern QEIDriver QEID4;
#endif

#if STM32_QEI_USE_TIM5 && !defined(__DOXYGEN__)
extern QEIDriver QEID5;
#endif

#if STM32_QEI_USE_TIM8 && !defined(__DOXYGEN__)
extern QEIDriver QEID8;
#endif

#if STM32_QEI_USE_TIM9 && !defined(__DOXYGEN__)
extern QEIDriver QEID9;
#endif

#ifdef __cplusplus
extern "C" {
#endif
  void qei_lld_init(void);
  void qei_lld_start(QEIDriver *qeip);
  void qei_lld_stop(QEIDriver *qeip);
  void qei_lld_enable(QEIDriver *qeip);
  void qei_lld_disable(QEIDriver *qeip);
#ifdef __cplusplus
}
#endif

#endif /* HAL_USE_QEI */

#endif /* _QEI_LLD_H_ */

/** @} */
