r2p-old/uDC_module/fw/qei_lld.c

/*
    ChibiOS/RT - Copyright (C) 2006,2007,2008,2009,2010,
                 2011,2012 Giovanni Di Sirio.

    This file is part of ChibiOS/RT.

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
    You should have received a copy of the GNU General Public License
    along with this program.  If not, see <http://www.gnu.org/licenses/>.
*/

/**
 * @file    STM32/qei_lld.c
 * @brief   STM32 QEI subsystem low level driver header.
 *
 * @addtogroup QEI
 * @{
 */

#include "ch.h"
#include "hal.h"
#include "qei.h"

#if HAL_USE_QEI || defined(__DOXYGEN__)

/*===========================================================================*/
/* Driver exported variables.                                                */
/*===========================================================================*/

/**
 * @brief   QEID1 driver identifier.
 * @note    The driver QEID1 allocates the complex timer TIM1 when enabled.
 */
#if STM32_QEI_USE_TIM1 || defined(__DOXYGEN__)
QEIDriver QEID1;
#endif

/**
 * @brief   QEID2 driver identifier.
 * @note    The driver QEID1 allocates the timer TIM2 when enabled.
 */
#if STM32_QEI_USE_TIM2 || defined(__DOXYGEN__)
QEIDriver QEID2;
#endif

/**
 * @brief   QEID3 driver identifier.
 * @note    The driver QEID1 allocates the timer TIM3 when enabled.
 */
#if STM32_QEI_USE_TIM3 || defined(__DOXYGEN__)
QEIDriver QEID3;
#endif

/**
 * @brief   QEID4 driver identifier.
 * @note    The driver QEID4 allocates the timer TIM4 when enabled.
 */
#if STM32_QEI_USE_TIM4 || defined(__DOXYGEN__)
QEIDriver QEID4;
#endif

/**
 * @brief   QEID5 driver identifier.
 * @note    The driver QEID5 allocates the timer TIM5 when enabled.
 */
#if STM32_QEI_USE_TIM5 || defined(__DOXYGEN__)
QEIDriver QEID5;
#endif

/**
 * @brief   QEID8 driver identifier.
 * @note    The driver QEID8 allocates the timer TIM8 when enabled.
 */
#if STM32_QEI_USE_TIM8 || defined(__DOXYGEN__)
QEIDriver QEID8;
#endif

/**
 * @brief   QEID9 driver identifier.
 * @note    The driver QEID9 allocates the timer TIM9 when enabled.
 */
#if STM32_QEI_USE_TIM9 || defined(__DOXYGEN__)
QEIDriver QEID9;
#endif

/*===========================================================================*/
/* Driver local variables.                                                   */
/*===========================================================================*/

/*===========================================================================*/
/* Driver local functions.                                                   */
/*===========================================================================*/

/*===========================================================================*/
/* Driver interrupt handlers.                                                */
/*===========================================================================*/

/*===========================================================================*/
/* Driver exported functions.                                                */
/*===========================================================================*/

/**
 * @brief   Low level QEI driver initialization.
 *
 * @notapi
 */
void qei_lld_init(void) {

#if STM32_QEI_USE_TIM1
  /* Driver initialization.*/
  qeiObjectInit(&QEID1);
  QEID1.tim = STM32_TIM1;
#endif

#if STM32_QEI_USE_TIM2
  /* Driver initialization.*/
  qeiObjectInit(&QEID2);
  QEID2.tim = STM32_TIM2;
#endif

#if STM32_QEI_USE_TIM3
  /* Driver initialization.*/
  qeiObjectInit(&QEID3);
  QEID3.tim = STM32_TIM3;
#endif

#if STM32_QEI_USE_TIM4
  /* Driver initialization.*/
  qeiObjectInit(&QEID4);
  QEID4.tim = STM32_TIM4;
#endif

#if STM32_QEI_USE_TIM5
  /* Driver initialization.*/
  qeiObjectInit(&QEID5);
  QEID5.tim = STM32_TIM5;
#endif

#if STM32_QEI_USE_TIM8
  /* Driver initialization.*/
  qeiObjectInit(&QEID8);
  QEID8.tim = STM32_TIM8;
#endif

#if STM32_QEI_USE_TIM9
  /* Driver initialization.*/
  qeiObjectInit(&QEID9);
  QEID9.tim = STM32_TIM9;
#endif
}

/**
 * @brief   Configures and activates the QEI peripheral.
 *
 * @param[in] qeip      pointer to the @p QEIDriver object
 *
 * @notapi
 */
void qei_lld_start(QEIDriver *qeip) {

  if (qeip->state == QEI_STOP) {
    /* Clock activation and timer reset.*/
#if STM32_QEI_USE_TIM1
    if (&QEID1 == qeip) {
      rccEnableTIM1(FALSE);
      rccResetTIM1();
    }
#endif
#if STM32_QEI_USE_TIM2
    if (&QEID2 == qeip) {
      rccEnableTIM2(FALSE);
      rccResetTIM2();
    }
#endif
#if STM32_QEI_USE_TIM3
    if (&QEID3 == qeip) {
      rccEnableTIM3(FALSE);
      rccResetTIM3();
    }
#endif
#if STM32_QEI_USE_TIM4
    if (&QEID4 == qeip) {
      rccEnableTIM4(FALSE);
      rccResetTIM4();
    }
#endif

#if STM32_QEI_USE_TIM5
    if (&QEID5 == qeip) {
      rccEnableTIM5(FALSE);
      rccResetTIM5();
    }
#endif
#if STM32_QEI_USE_TIM8
    if (&QEID8 == qeip) {
      rccEnableTIM8(FALSE);
      rccResetTIM8();
    }
#endif
#if STM32_QEI_USE_TIM9
    if (&QEID9 == qeip) {
      rccEnableTIM9(FALSE);
      rccResetTIM9();
    }
#endif
  }
   /* Timer configuration.*/
  qeip->tim->CR1  = 0;                      /* Initially stopped.           */
  qeip->tim->CR2  = 0;
  qeip->tim->PSC  = 0;
  qeip->tim->DIER = 0;
  qeip->tim->ARR   = 0xFFFF;

  /* Set Capture Compare 1 and Capture Compare 2 as input. */
   qeip->tim->CCMR1 |= TIM_CCMR1_CC1S_0 | TIM_CCMR1_CC2S_0;

  switch (qeip->config->mode) {
  case  QEI_MODE_QUADRATURE:
    if (qeip->config->resolution == QEI_BOTH_EDGES)
      qeip->tim->SMCR  = TIM_SMCR_SMS_1 | TIM_SMCR_SMS_0;
    else
      qeip->tim->SMCR  = TIM_SMCR_SMS_0;
    break;
  case QEI_MODE_DIRCLOCK1:
    /* Direction/Clock mode 1.
     * Direction input on TI1, Clock input on TI2. */
    qeip->tim->SMCR  = TIM_SMCR_SMS_0;
    break;
  case QEI_MODE_DIRCLOCK2:
    /* Direction/Clock mode 2.
     * Clock input on TI1, Direction input on TI2. */
    qeip->tim->SMCR  = TIM_SMCR_SMS_1;
    break;
  default:
	/* Unsupported mode. */
	/* TODO: how to handle? */
	break;
  }

  if (qeip->config->dirinv == QEI_DIRINV_TRUE)
	    qeip->tim->CCER = TIM_CCER_CC1E | TIM_CCER_CC1P | TIM_CCER_CC2E;
  else
    qeip->tim->CCER = TIM_CCER_CC1E | TIM_CCER_CC2E;
}

/**
 * @brief   Deactivates the QEI peripheral.
 *
 * @param[in] qeip      pointer to the @p QEIDriver object
 *
 * @notapi
 */
void qei_lld_stop(QEIDriver *qeip) {

  if (qeip->state == QEI_READY) {
    qeip->tim->CR1  = 0;                    /* Timer disabled.              */

    /* Clock deactivation.*/
#if STM32_QEI_USE_TIM1
    if (&QEID1 == qeip) {
      rccDisableTIM1(FALSE);
    }
#endif
#if STM32_QEI_USE_TIM2
    if (&QEID2 == qeip) {
      rccDisableTIM2(FALSE);
    }
#endif
#if STM32_QEI_USE_TIM3
    if (&QEID3 == qeip) {
      rccDisableTIM3(FALSE);
    }
#endif
#if STM32_QEI_USE_TIM4
    if (&QEID4 == qeip) {
      rccDisableTIM4(FALSE);
    }
#endif
#if STM32_QEI_USE_TIM5
    if (&QEID5 == qeip) {
      rccDisableTIM5(FALSE);
    }
#endif
  }
#if STM32_QEI_USE_TIM8
    if (&QEID8 == qeip) {
      rccDisableTIM8(FALSE);
    }
#endif
#if STM32_QEI_USE_TIM9
    if (&QEID9 == qeip) {
      rccDisableTIM9(FALSE);
    }
#endif
}

/**
 * @brief   Enables the input capture.
 *
 * @param[in] qeip      pointer to the @p QEIDriver object
 *
 * @notapi
 */
void qei_lld_enable(QEIDriver *qeip) {

  qeip->tim->CR1  = TIM_CR1_CEN;            /* Timer enabled.               */
}

/**
 * @brief   Disables the input capture.
 *
 * @param[in] qeip      pointer to the @p QEIDriver object
 *
 * @notapi
 */
void qei_lld_disable(QEIDriver *qeip) {

    qeip->tim->CR1  = 0;                    /* Timer disabled.              */
}

#endif /* HAL_USE_QEI */

/** @} */
