r2p-old/uDC_module/fw/qei.c

/*
 ChibiOS/RT - Copyright (C) 2006,2007,2008,2009,2010,
 2011,2012 Giovanni Di Sirio.

 This file is part of ChibiOS/RT.

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
 You should have received a copy of the GNU General Public License
 along with this program.  If not, see <http://www.gnu.org/licenses/>.
 */

/**
 * @file    qei.c
 * @brief   QEI Driver code.
 *
 * @addtogroup QEI
 * @{
 */

#include "ch.h"
#include "hal.h"
#include "qei.h"

#if HAL_USE_QEI || defined(__DOXYGEN__)

/*===========================================================================*/
/* Driver local definitions.                                                 */
/*===========================================================================*/

/*===========================================================================*/
/* Driver exported variables.                                                */
/*===========================================================================*/

/*===========================================================================*/
/* Driver local variables.                                                   */
/*===========================================================================*/

/*===========================================================================*/
/* Driver local functions.                                                   */
/*===========================================================================*/

/*===========================================================================*/
/* Driver exported functions.                                                */
/*===========================================================================*/

/**
 * @brief   QEI Driver initialization.
 * @note    This function is implicitly invoked by @p halInit(), there is
 *          no need to explicitly initialize the driver.
 *
 * @init
 */
void qeiInit(void) {

	qei_lld_init();
}

/**
 * @brief   Initializes the standard part of a @p QEIDriver structure.
 *
 * @param[out] qeip     pointer to the @p QEIDriver object
 *
 * @init
 */
void qeiObjectInit(QEIDriver *qeip) {

	qeip->state = QEI_STOP;
	qeip->last = 0;
	qeip->config = NULL;
}

/**
 * @brief   Configures and activates the QEI peripheral.
 *
 * @param[in] qeip      pointer to the @p QEIDriver object
 * @param[in] config    pointer to the @p QEIConfig object
 *
 * @api
 */
void qeiStart(QEIDriver *qeip, const QEIConfig *config) {

	chDbgCheck((qeip != NULL) && (config != NULL), "qeiStart");

	chSysLock();
	chDbgAssert((qeip->state == QEI_STOP) || (qeip->state == QEI_READY),
			"qeiStart(), #1", "invalid state");
	qeip->config = config;
	qei_lld_start(qeip);
	qeip->state = QEI_READY;
	chSysUnlock();
}

/**
 * @brief   Deactivates the QEI peripheral.
 *
 * @param[in] qeip      pointer to the @p QEIDriver object
 *
 * @api
 */
void qeiStop(QEIDriver *qeip) {

	chDbgCheck(qeip != NULL, "qeiStop");

	chSysLock();
	chDbgAssert((qeip->state == QEI_STOP) || (qeip->state == QEI_READY),
			"qeiStop(), #1", "invalid state");
	qei_lld_stop(qeip);
	qeip->state = QEI_STOP;
	chSysUnlock();
}

/**
 * @brief   Enables the quadrature encoder interface.
 *
 * @param[in] qeip      pointer to the @p QEIDriver object
 *
 * @api
 */
void qeiEnable(QEIDriver *qeip) {

	chDbgCheck(qeip != NULL, "qeiEnable");

	chSysLock();
	chDbgAssert(qeip->state == QEI_READY, "qeiEnable(), #1", "invalid state");
	qei_lld_enable(qeip);
	qeip->state = QEI_ACTIVE;
	chSysUnlock();
}

/**
 * @brief   Disables the quadrature encoder interface.
 *
 * @param[in] qeip      pointer to the @p QEIDriver object
 *
 * @api
 */
void qeiDisable(QEIDriver *qeip) {

	chDbgCheck(qeip != NULL, "qeiDisable");

	chSysLock();
	chDbgAssert((qeip->state == QEI_READY) || (qeip->state == QEI_ACTIVE),
			"qeiDisable(), #1", "invalid state");
	qei_lld_disable(qeip);
	qeip->state = QEI_READY;
	chSysUnlock();
}

/**
 * @brief   Returns the counter value.
 *
 * @param[in] qeip      pointer to the @p QEIDriver object
 * @return              The current counter value.
 *
 * @api
 */
qeicnt_t qeiGetCount(QEIDriver *qeip) {
	qeicnt_t cnt;

	chSysLock();
	cnt = qeiGetCountI(qeip);
	chSysUnlock();

	return cnt;
}

/**
 * @brief   Returns the counter delta from last reading.
 *
 * @param[in] qeip      pointer to the @p QEIDriver object
 * @return              The delta from last read.
 *
 * @api
 */
qeidelta_t qeiUpdate(QEIDriver *qeip) {
	qeicnt_t diff;

	chSysLock();
	diff = qeiUpdateI(qeip);
	chSysUnlock();

	return diff;
}

/**
 * @brief   Returns the counter delta from last reading.
 *
 * @param[in] qeip      pointer to the @p QEIDriver object
 * @return              The delta from last read.
 *
 * @iclass
 */
qeidelta_t qeiUpdateI(QEIDriver *qeip) {
	qeicnt_t cnt;
	qeidelta_t delta;

	chDbgCheckClassI();
	chDbgCheck(qeip != NULL, "qeiUpdate");
	chDbgAssert((qeip->state == QEI_READY) || (qeip->state == QEI_ACTIVE),
			"qeiUpdate(), #1", "invalid state");

	cnt = qei_lld_get_count(qeip);
	delta = cnt - qeip->last;
	qeip->last = cnt;

	return delta;
}

#endif /* HAL_USE_QEI */

/** @} */
