r2p-old/uDC_module/(commit log)

2014-05-29 added motor driver datasheet
2014-05-29 ongoing layout
    [uDC_module.brd, uDC_module.sch]
2014-05-30 hi-power section layout completed
    [uDC_module.brd]
2014-05-30 working on signal routing
    [uDC_module.brd, uDC_module.sch]
2014-05-30 working on signal routin
    [uDC_module.brd, uDC_module.sch]
2014-06-03 routing encoder signals
    [uDC_module.brd]
2014-06-03 layout completed
    [uDC_module.brd, uDC_module.sch]
2014-06-04 updated all connectors to have GND on pin 1
    [uDC_module.brd, uDC_module.sch]
2014-06-13 final revision
    [uDC_module.brd, uDC_module.sch]
2014-06-23 Added makefile for quicker gerber generation
    [uDC_module.brd]
2014-06-24 added PNG of board layout
2014-07-31 added blinking led firmware
    [uDC_module.brd]
2014-08-08 moved IN2 to TIM1 ch2
    [uDC_module.brd, uDC_module.sch]
2014-08-08 updated config to STM32F3 and added hardware_test firmware
2014-12-16 small fixes for production
    [uDC_module.brd, uDC_module.sch]
2014-12-29 approved DRC false errors
    [uDC_module.brd]
2015-01-08 added logo to bottom silkscreen
    [uDC_module.brd, uDC_module.sch]
2015-01-13 minor fixes for manufacturing
    [uDC_module.brd, uDC_module.sch]
2015-01-22 added assembly PDF generation
    [uDC_module.brd, uDC_module.sch]
